curiouselectric/RandomLED/README.md

# RandomLED
A DIY kit to make a solar powered Dice or 8-Ball Unit
