curiouselectric/RandomLED/SolarRandom_PCB/Solar8Ball/circuitdiagram_v1.png

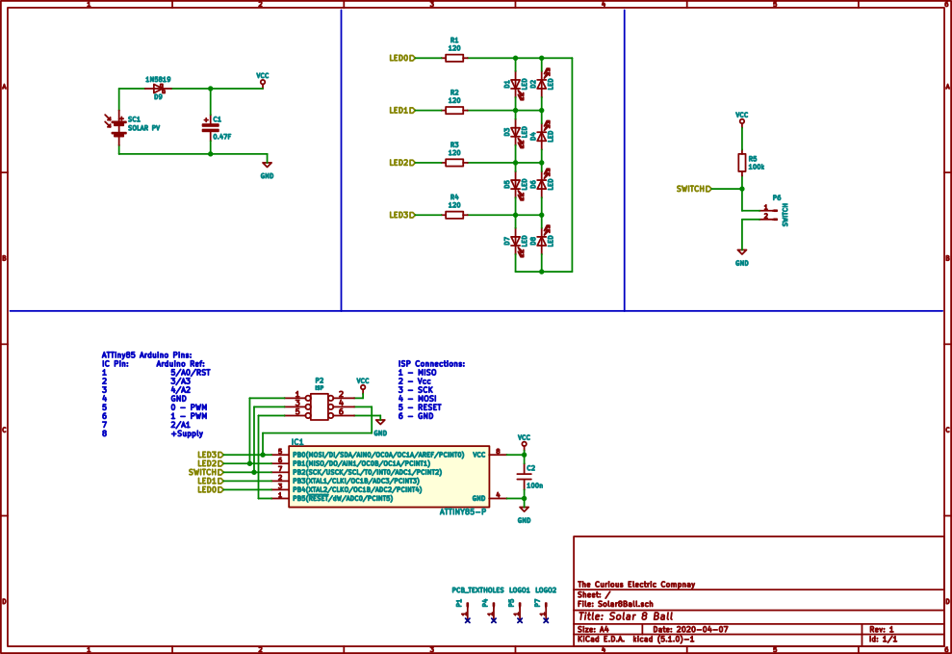
SolarRandom_PCB/Solar8Ball/circuitdiagram_v1.png
