curiouselectric/RandomLED/SolarRandom_Instructions/Solar 8 Ball - Circuit Schematic.pdf

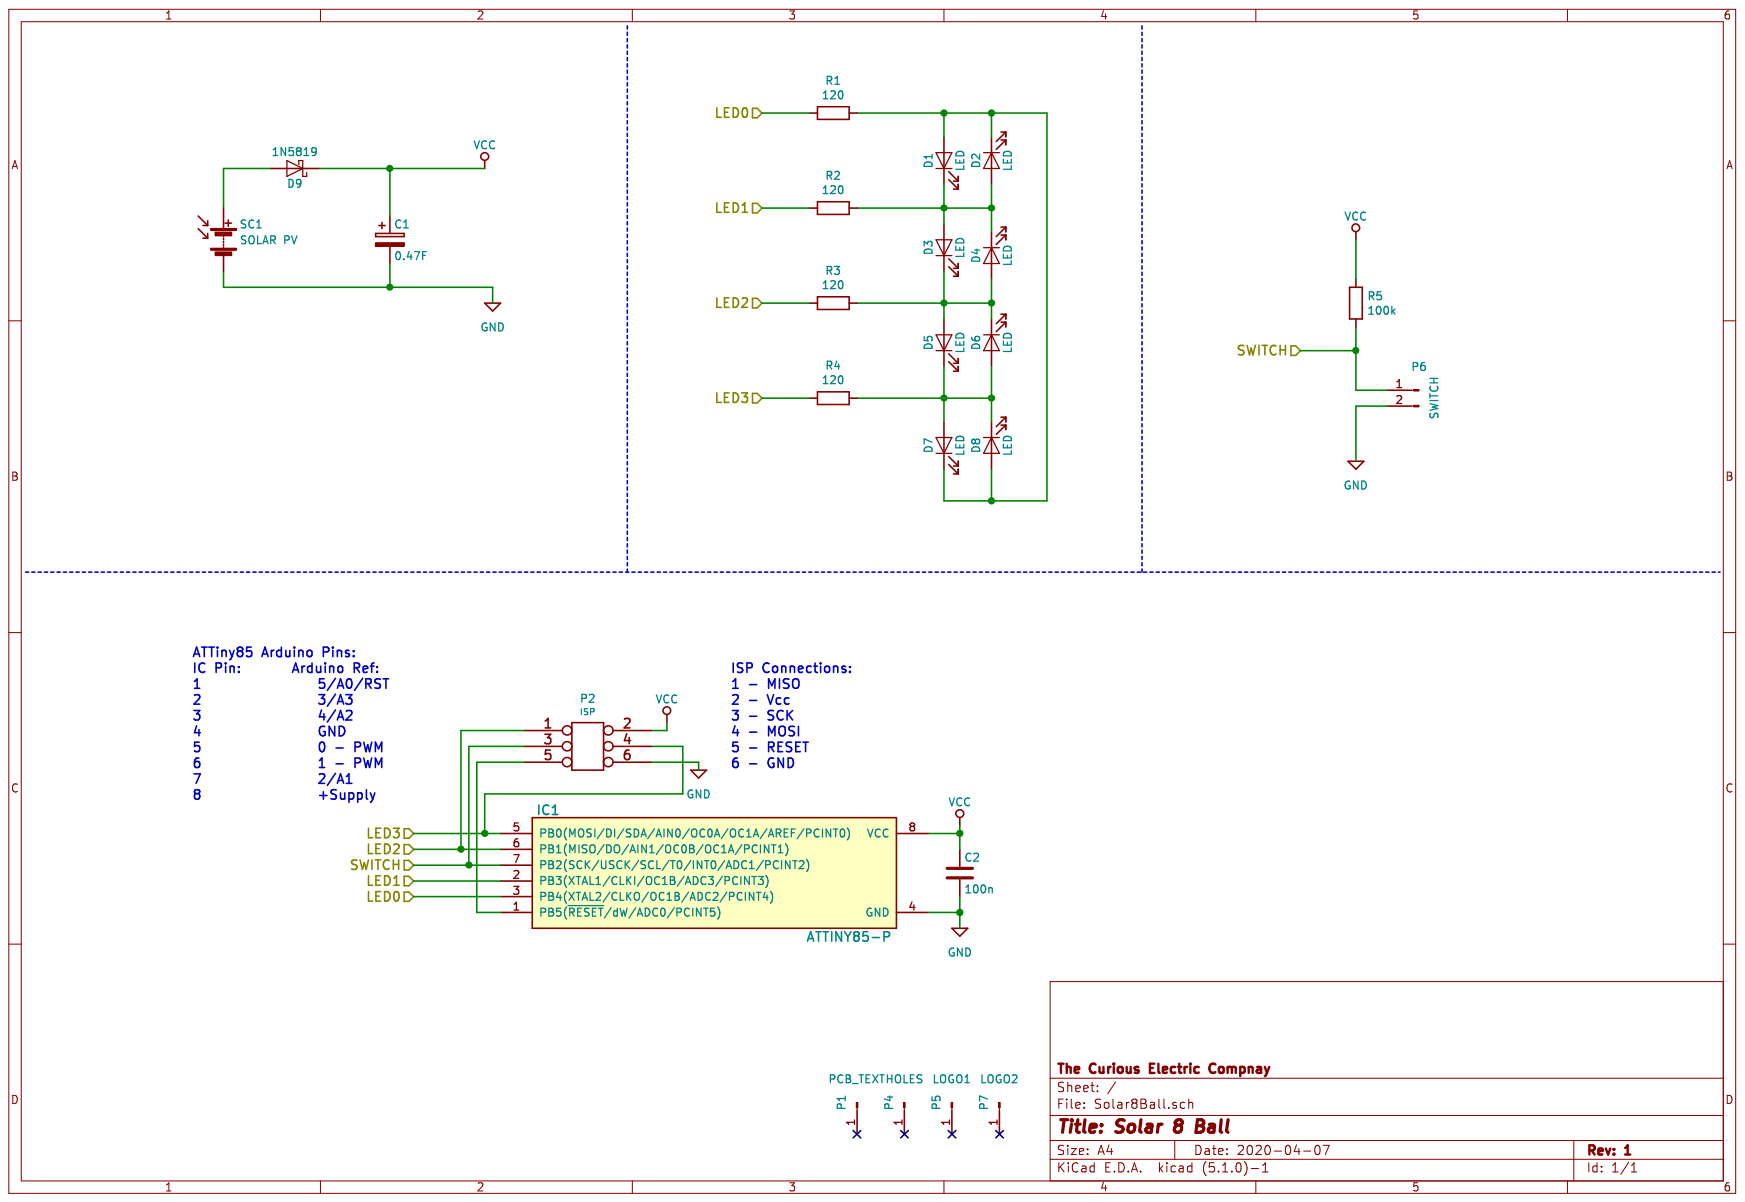
[picture p26: page 1]
