curiouselectric/RandomLED/SolarRandom_Instructions/Solar Dice - Circuit Schematic.pdf

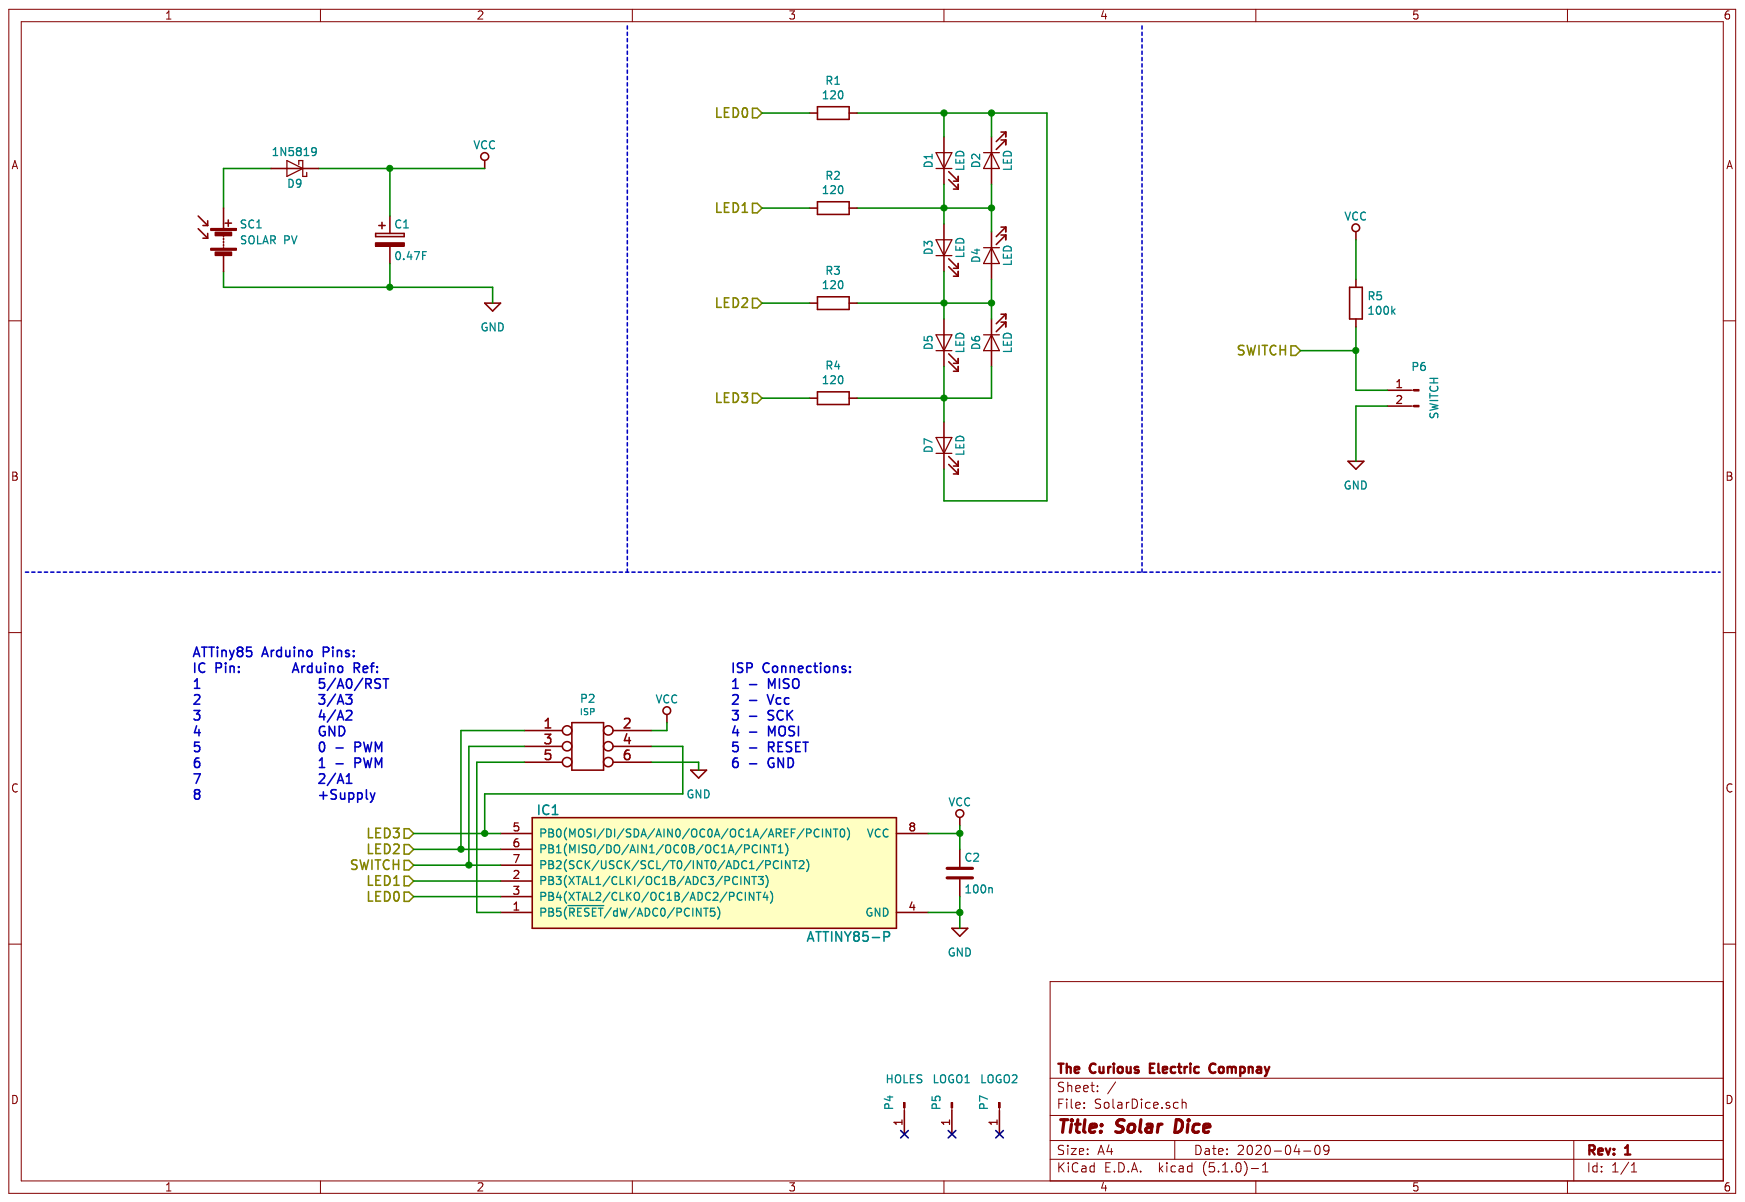
[picture p27: page 1]
