curiouselectric/RandomLED/SolarRandom_PCB/Solar8Ball/Solar8Ball.pdf

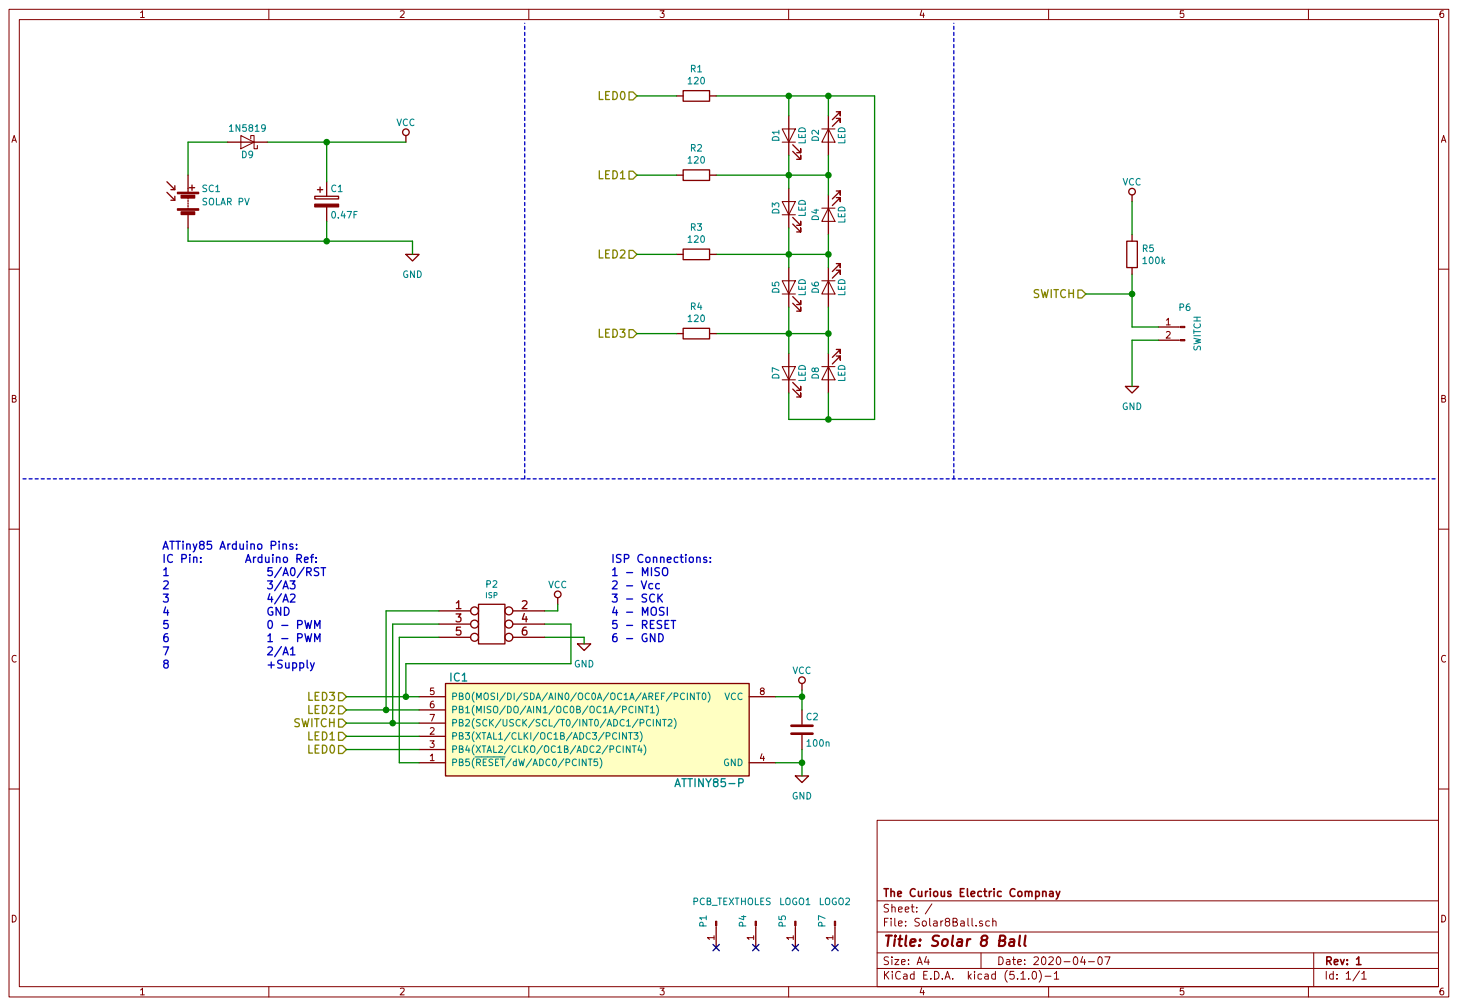
[picture p28: page 1]

Id: 1/1 Title: Solar 8 Ball File: Solar8Ball.sch Sheet: / The Curious Electric Compnay
