curiouselectric/RandomLED/SolarRandom_PCB/SolarTimer/SolarTimer.kicad_pcb

## KiCad design SolarRandom_PCB/SolarTimer/SolarTimer.kicad_pcb (2020-05-22)

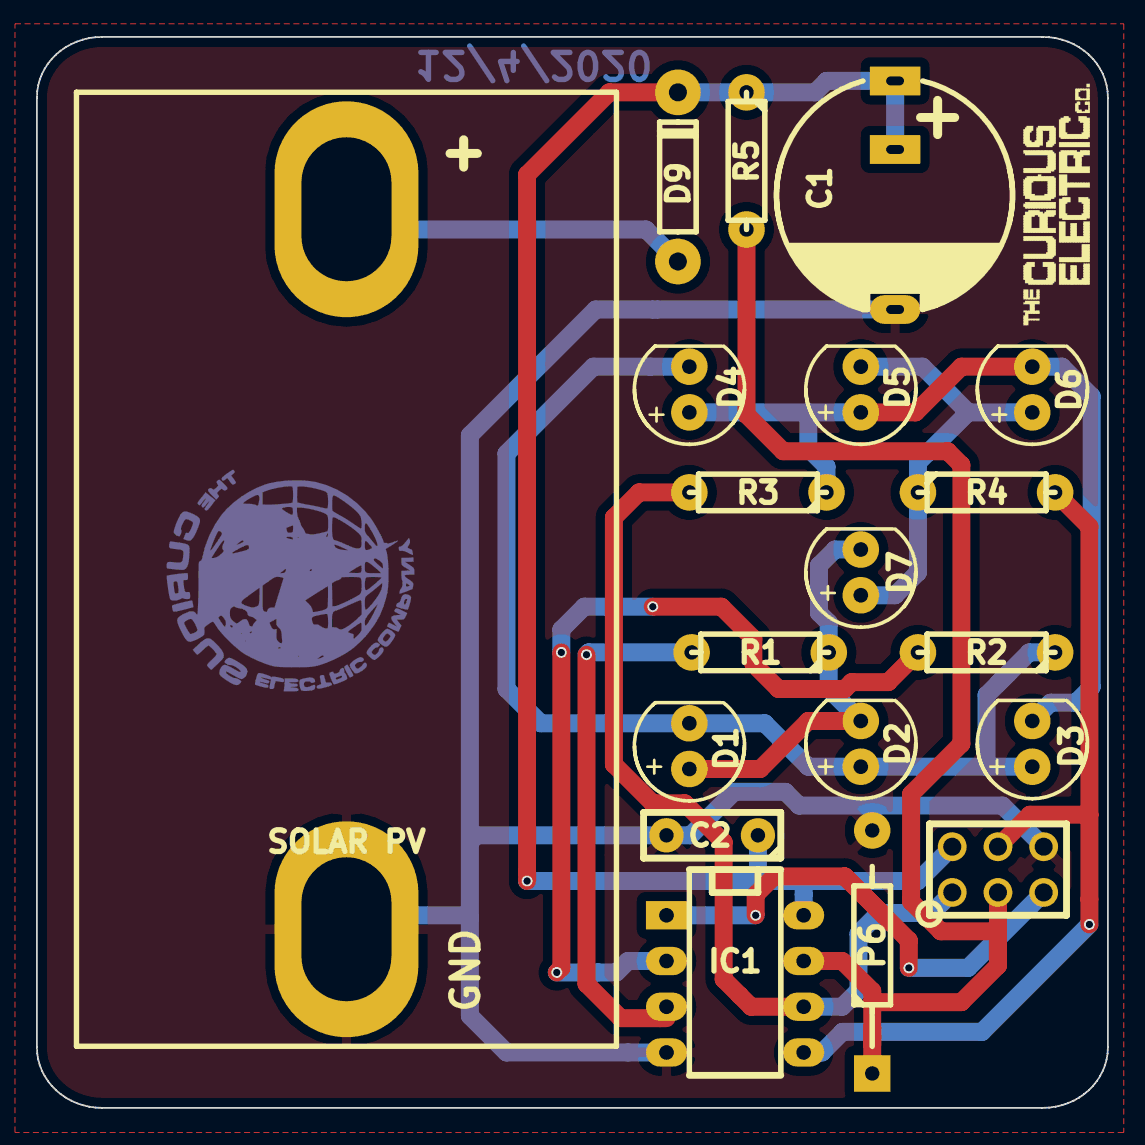
[picture p29: board SolarTimer.kicad_pcb from above]

Board: 2 copper layers, 59.5 x 59.5 mm, 22 parts (0 on the bottom side), 13 nets.

Parts:
C1: 0.47F; C_0_47F_SuperCap_2POS
C2: 100n; C1_wide_lg_pad_2
D1, D2, D3, D4, D5, D6, D7: LED; LED-5MM_larg_pad
D9: 1N5819; TH_Diode_1
IC1: ATTINY85-P; DIP-8_300_ELL
P2: ISP; ISP_3x2
P4: HOLES; SolarDicePCB
P5: LOGO1; 2020_04_14_CuriousElectricCompany_Logo_Round_15mm_BCu
P6: SWITCH; TH_SW_SW200D
P7: LOGO2; TCEC_Words_13mm
R1, R2, R3, R4: 120; R3-LARGE_PADS_0_8_hole
R5: 100k; R3-LARGE_PADS_0_8_hole
SC1: SOLAR PV; PV_53x30mm_Area

Connections:
/LED0: IC1.3, R1.2
/LED1: IC1.2, R2.2
/LED2: IC1.6, P2.1, R3.2
/LED3: IC1.5, P2.4, R4.2
/SWITCH: IC1.7, P2.3, P6.1, R5.2
GND: C1.2, C2.2, IC1.4, P2.6, P6.2, SC1.2
unnamed: D1.1, D2.2, D7.2, R1.1
unnamed: D1.2, D2.1, D3.1, D4.2, R2.1
unnamed: D3.2, D4.1, D5.1, D6.2, R3.1
unnamed: D5.2, D6.1, D7.1, R4.1
unnamed: D9.2, SC1.1
unnamed: IC1.1, P2.5
VCC: C1.1, C2.1, D9.1, IC1.8, P2.2, R5.1
