curiouselectric/RandomLED/(commit log)

2020-04-09 Initial Commit of PCB and firmware
    [Solar8Ball.kicad_pcb, Solar8Ball.sch]
2020-04-09 Updated PCBs
    [Solar8Ball.kicad_pcb, Solar8Ball.sch, SolarDice.kicad_pcb, SolarDice.sch]
2020-05-14 Updated Software and PCB design
    [Solar8Ball-B_Cu.gbr, Solar8Ball-B_Mask.gbr, Solar8Ball-B_SilkS.gbr, Solar8Ball-Edge_Cuts.gbr, Solar8Ball-F_Cu.gbr, Solar8Ball-F_Mask.gbr, Solar8Ball-F_SilkS.gbr, Solar8Ball.drl]
2020-05-22 PCB and instructions
    [Solar8Ball-B_Cu.gbr, Solar8Ball-B_Mask.gbr, Solar8Ball-B_SilkS.gbr, Solar8Ball-Edge_Cuts.gbr, Solar8Ball-F_Cu.gbr, Solar8Ball-F_Mask.gbr, Solar8Ball-F_SilkS.gbr, Solar8Ball.drl]
2022-07-15 updated ins tructions
    [Solar8Ball-B_Cu.gbr, Solar8Ball-B_Mask.gbr, Solar8Ball-B_SilkS.gbr, Solar8Ball-Edge_Cuts.gbr, Solar8Ball-F_Cu.gbr, Solar8Ball-F_Mask.gbr, Solar8Ball-F_SilkS.gbr, Solar8Ball.drl]
